slash128v6/DC28_Jack_Attack_Badge/eagle/Parts/1451-01.jpg

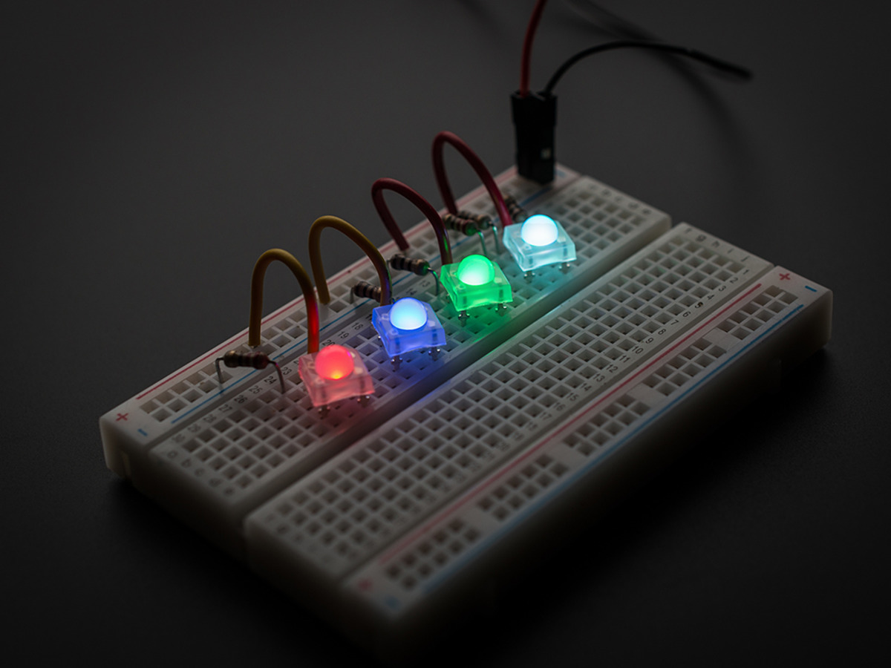
eagle/Parts/1451-01.jpg
