slash128v6/DC28_Jack_Attack_Badge/eagle/Media/DC-Jack_100x100_White-on-Black.bmp

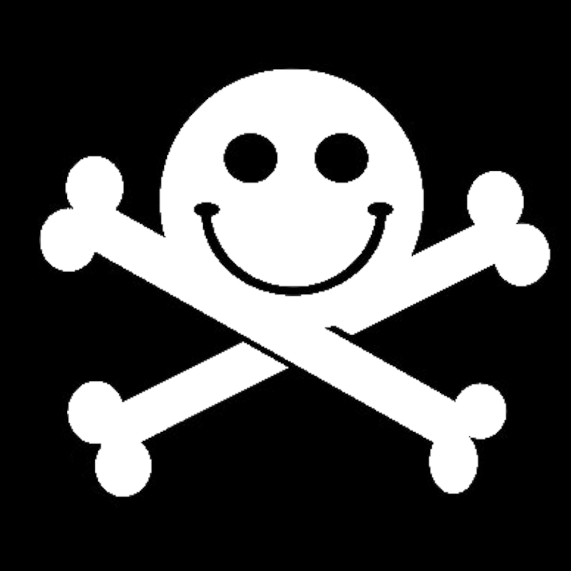
eagle/Media/DC-Jack_100x100_White-on-Black.bmp
