slash128v6/DC28_Jack_Attack_Badge/eagle/Parts/1334228050572109244.jpg

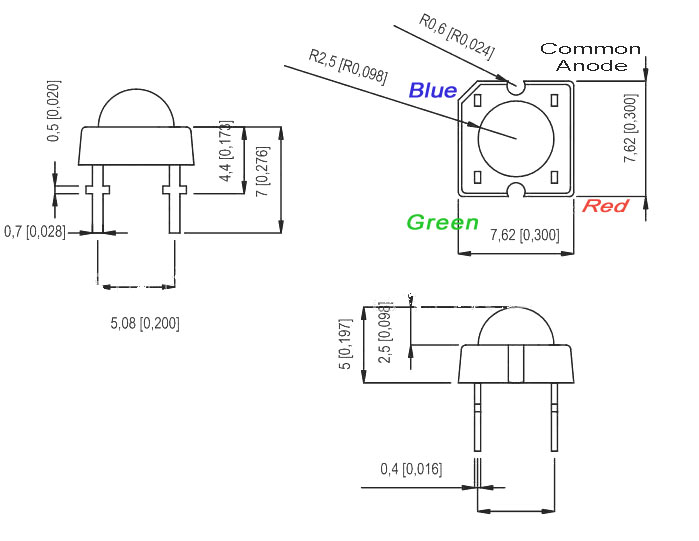
eagle/Parts/1334228050572109244.jpg
