slash128v6/DC28_Jack_Attack_Badge/eagle/Parts/1026.PDF

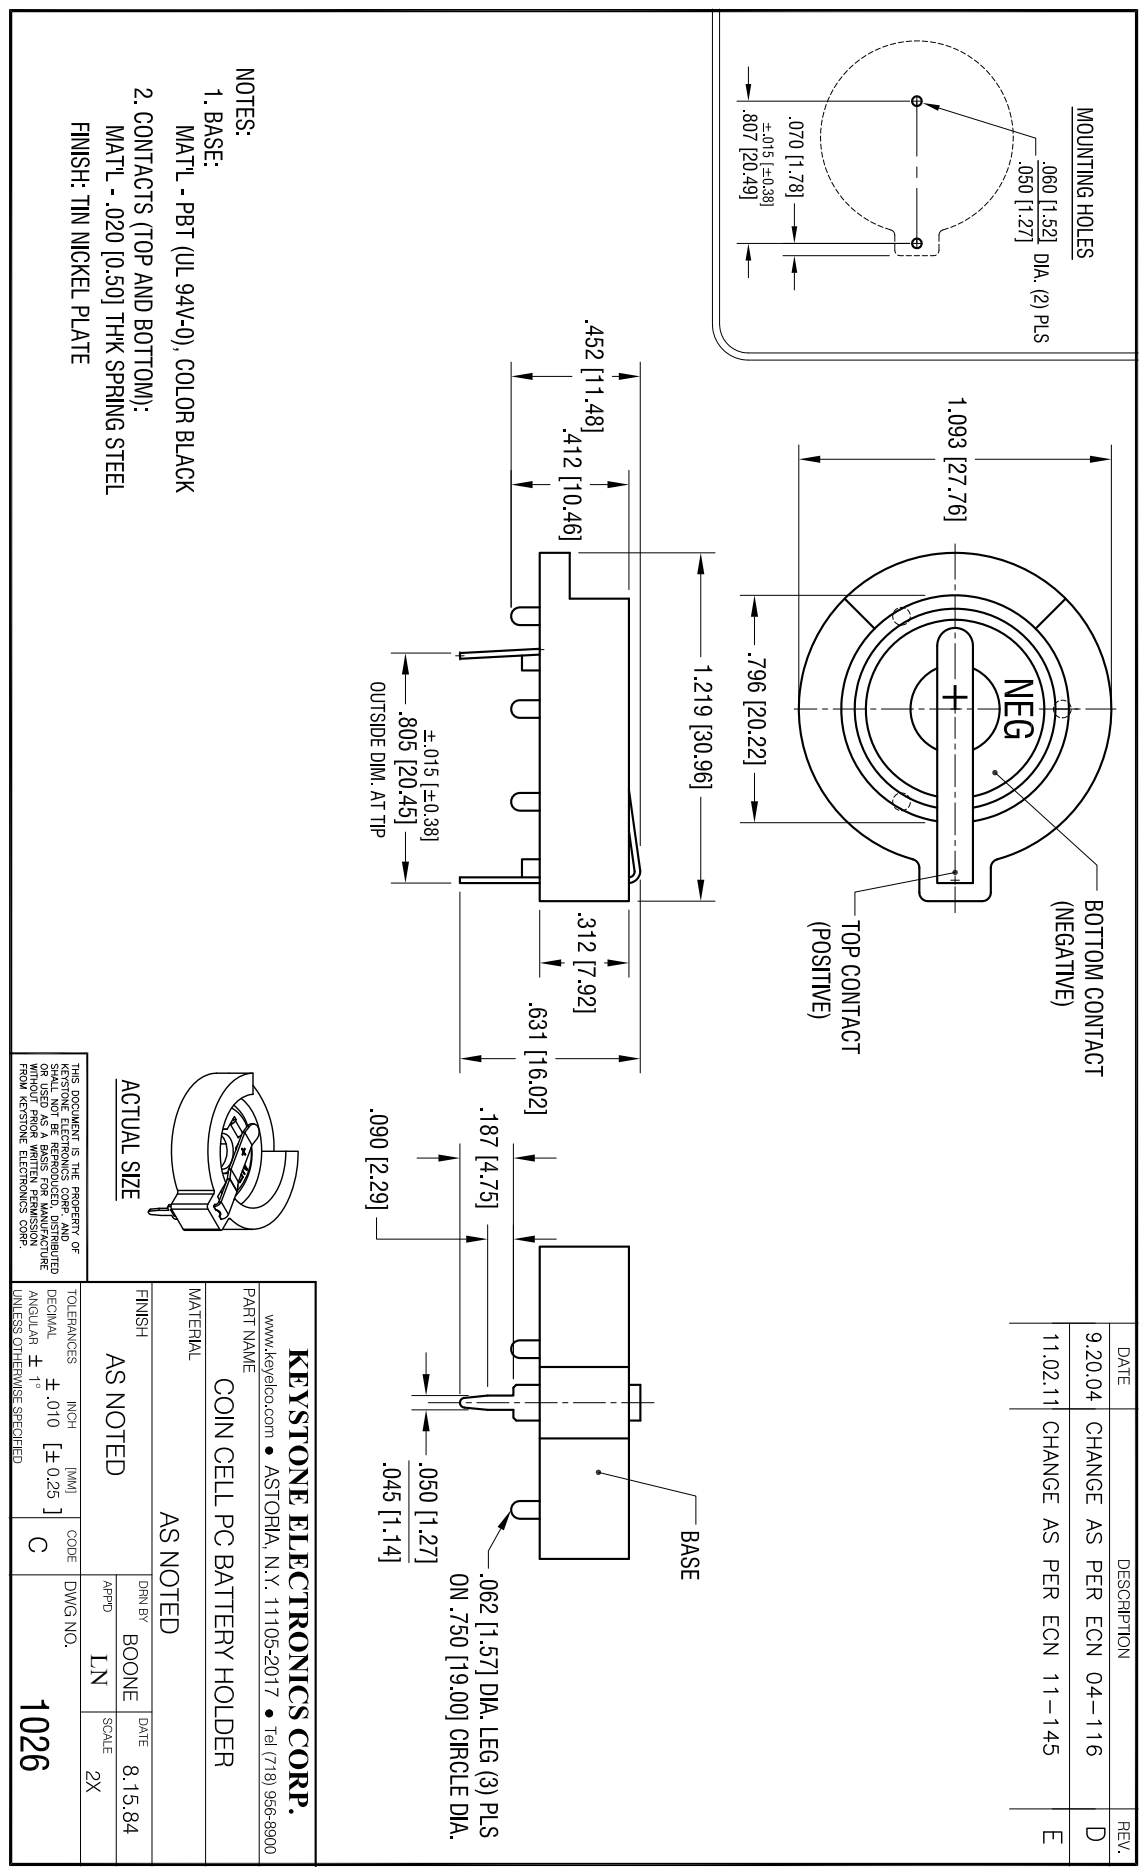
[picture p4: page 1]
