slash128v6/DC28_Jack_Attack_Badge/eagle/Output/Schematic/DC28_Jack-Attack_Badge.pdf

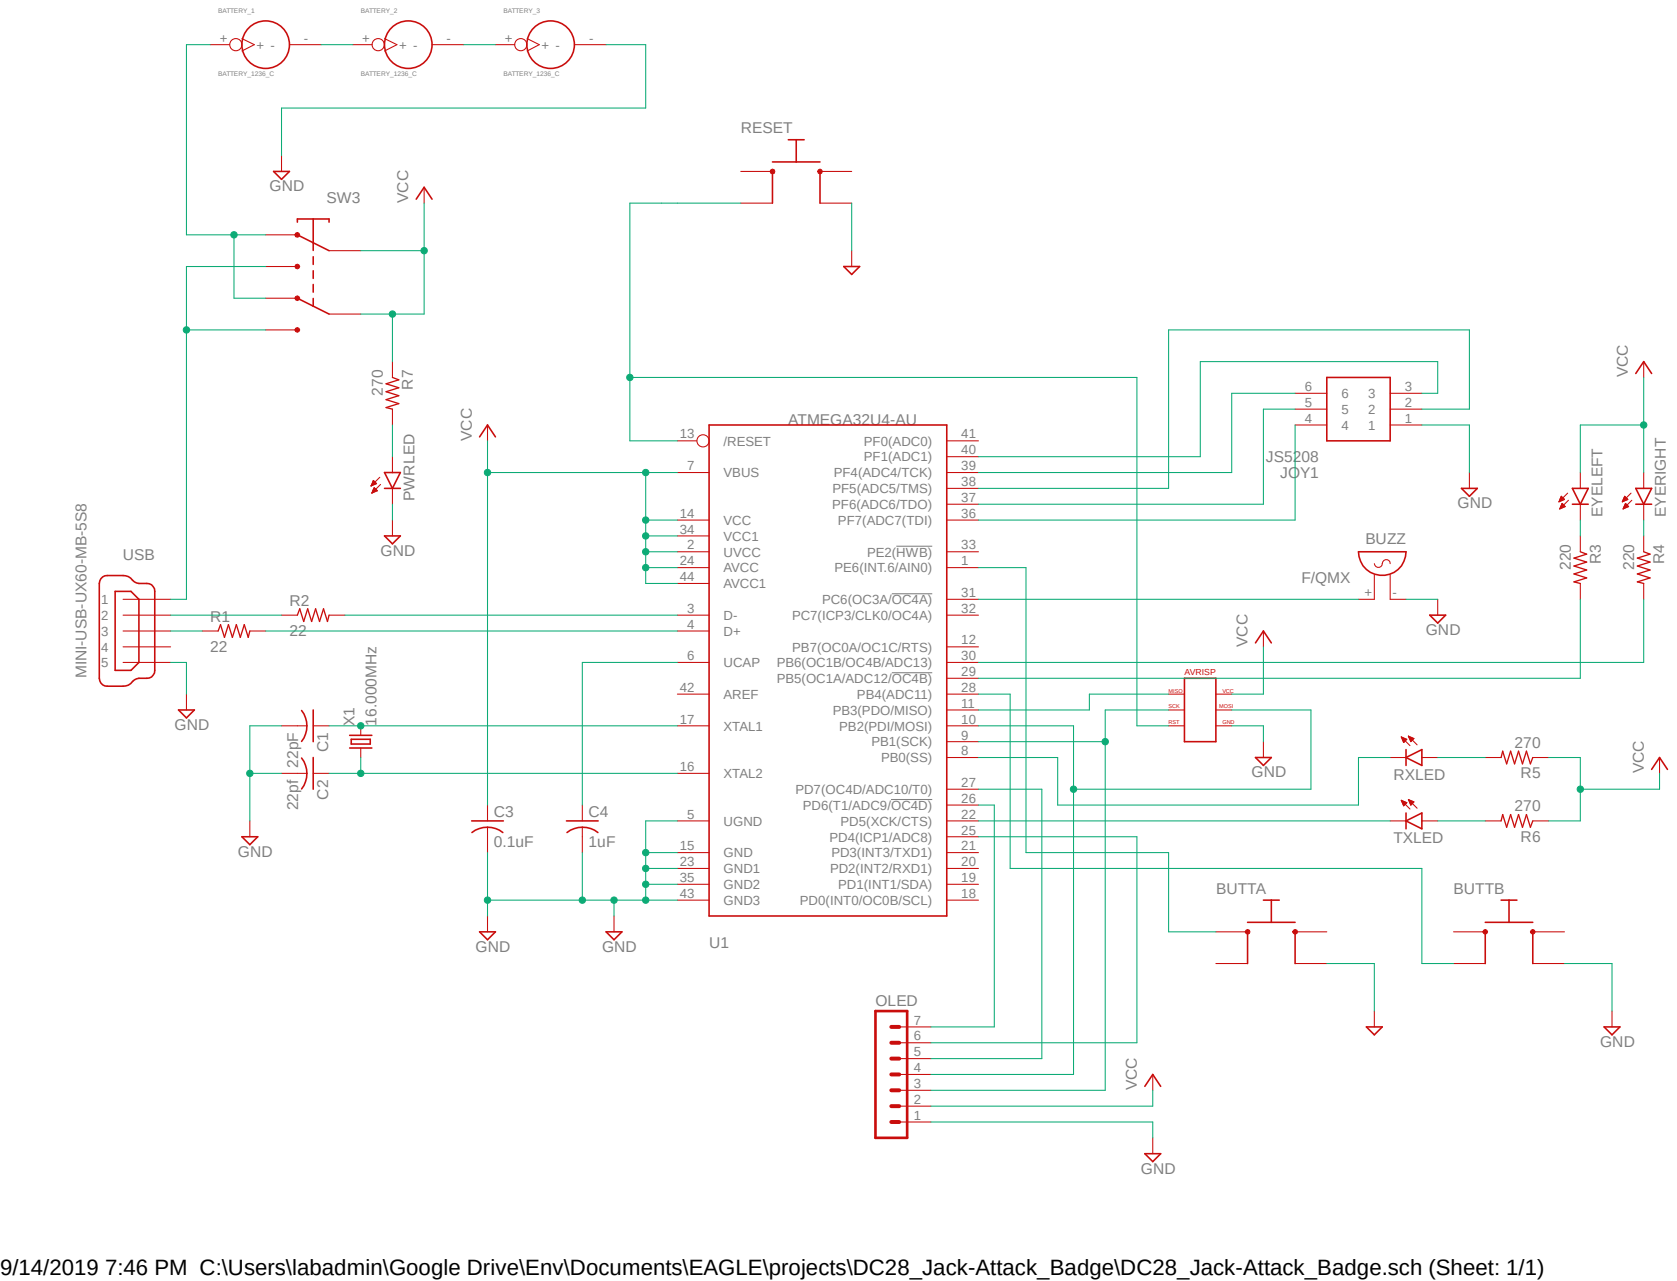
[picture p5: page 1]

AVRISP

MISO
