slash128v6/DC28_Jack_Attack_Badge/eagle/Output/Gerber/DC28_Jack-Attack_Badge-4_2019-11-18_Bottom.pdf

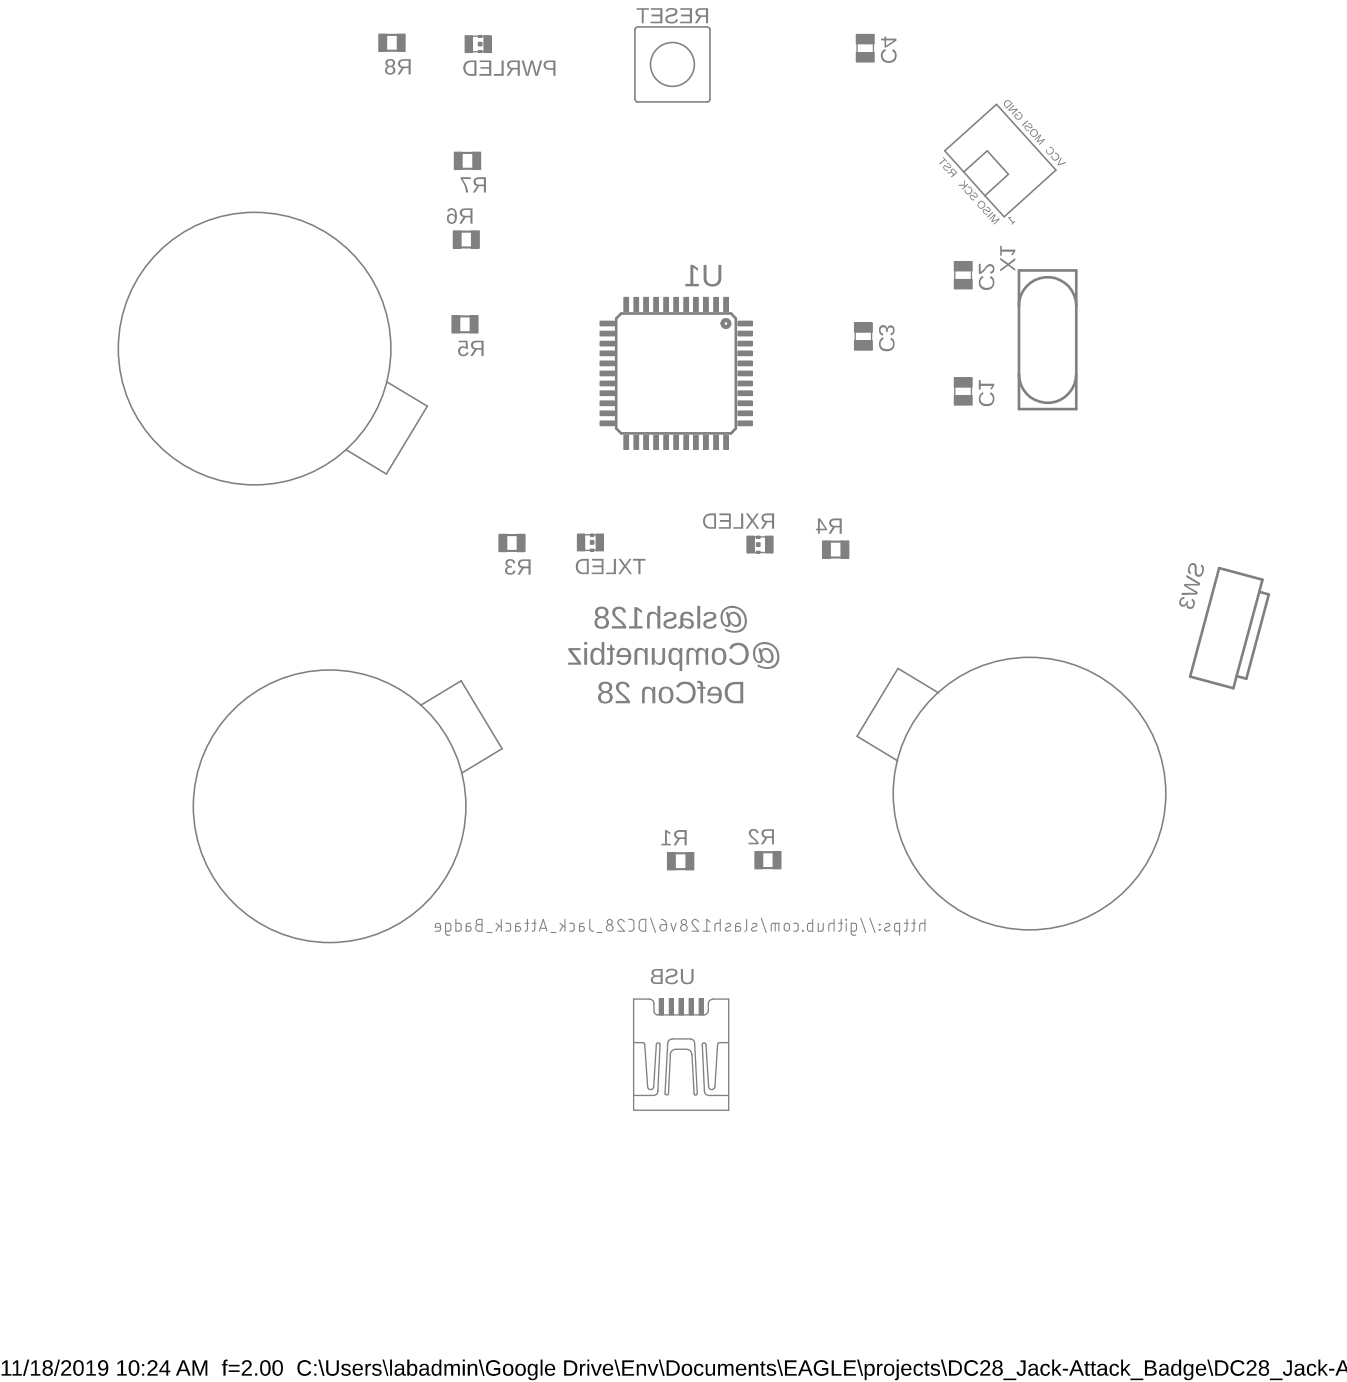
[picture p6: page 1]
