slash128v6/DC28_Jack_Attack_Badge/eagle/DC28_Jack-Attack_Badge-2.brd

## EAGLE design eagle/DC28_Jack-Attack_Badge-2.brd (2020-02-04)

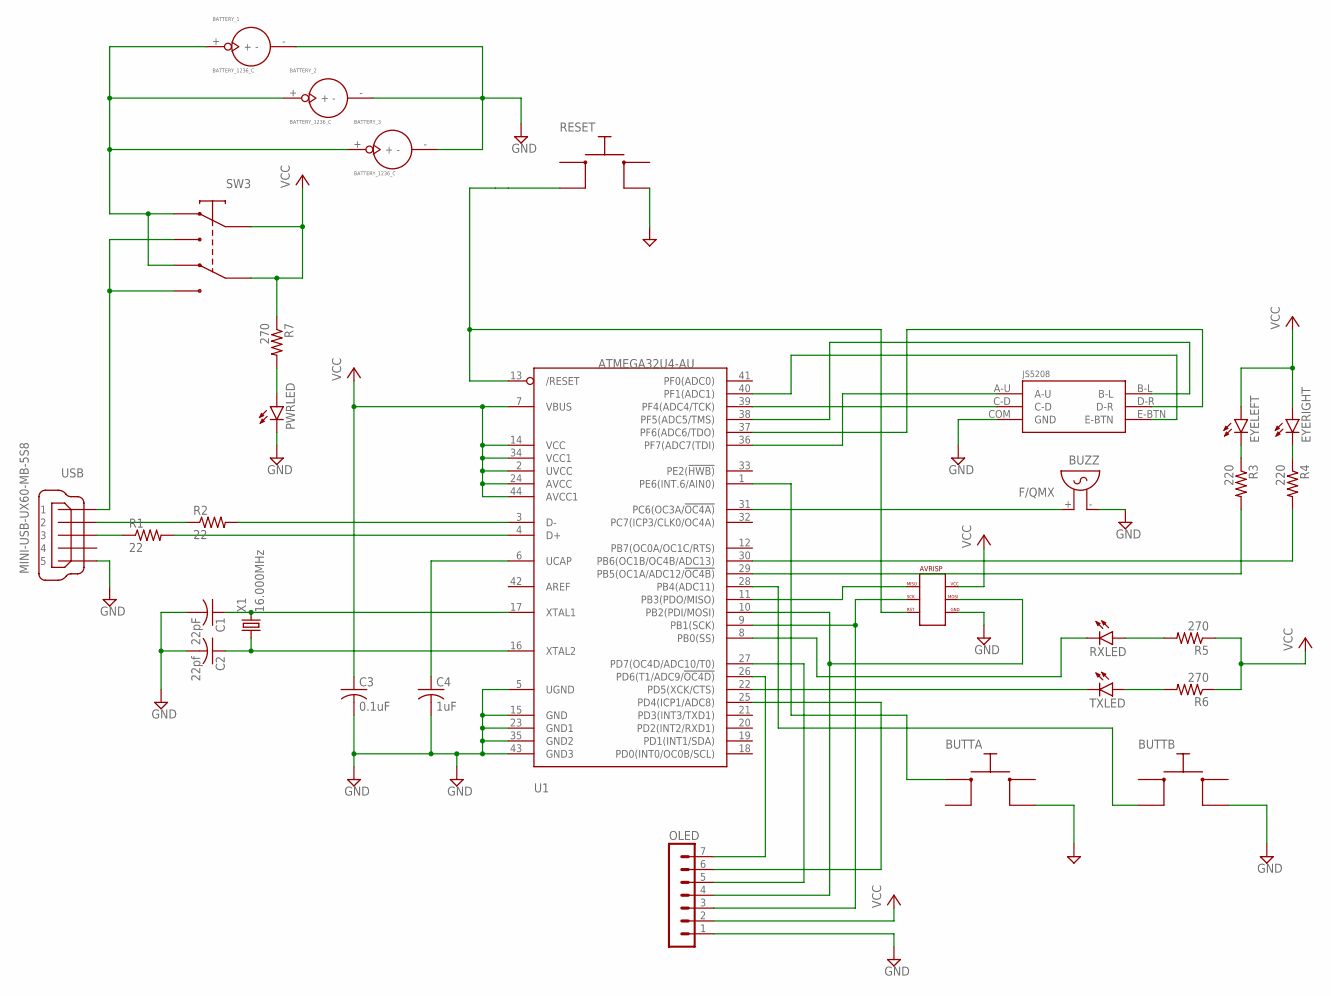
[picture p8: schematic DC28_Jack-Attack_Badge-2.sch]

Parts:
BATTERY_1, BATTERY_2, BATTERY_3: BATTERY_1236_C
BUTTA: PTS645; PTS645_SMD
BUTTB: PTS645; PTS645_SMD
BUZZ: F/QMX
C1: 22pF; C0805
C2: 22pf; C0805
C3: 0.1uF; C0805
C4: 1uF; C0805
EYELEFT: LED5MM
EYERIGHT: LED5MM
OLED: MA07-1
PWRLED: LEDCHIP-LED0805; CHIP-LED0805
R1, R2: 22; R0805
R3, R4: 220; R0805
R5, R6, R7: 270; R0805
RESET: PTS645; PTS645_SMD
RXLED: LEDCHIP-LED0805; CHIP-LED0805
SW3: JS202011AQN
TXLED: LEDCHIP-LED0805; CHIP-LED0805
U1: ATMEGA32U4-AU; TQFP44
U$1: AVRISP_POGO
U$2: JS5208; JS5208_PKG
USB: MINI-USB-UX60-MB-5S8; UX60-MB-5S8
X1: 16.000MHz; CSM-7X-DU

Connections:
BATT1: BATTERY_1.+, BATTERY_2.+, BATTERY_3.+, SW3.P$1 (1), SW3.P$4 (4)
GND: BATTERY_1.-, BATTERY_2.-, BATTERY_3.-, BUTTA.P$4 (4), BUTTB.P$4 (4), BUZZ.- (1), C1.2, C2.2, C3.2, C4.2, OLED.1, PWRLED.C, RESET.P$4 (4), U1.5 (UGND), U1.15 (GND), U1.23 (GND1), U1.35 (GND2), U1.43 (GND3), U$1.P$6, U$1.P$6B, U$2.COM (GND), USB.5
unnamed: R1.1, USB.3
unnamed: R2.2, U1.3 (D-)
unnamed: R2.1, USB.2
unnamed: R1.2, U1.4 (D+)
unnamed: C4.1, U1.6 (UCAP)
unnamed: BUTTA.P$1 (1), U1.1 (PE6(INT.6/AIN0))
unnamed: C2.1, U1.16 (XTAL2), X1.1
unnamed: C1.1, U1.17 (XTAL1), X1.2
unnamed: U1.36 (PF7(ADC7(TDI)), U$2.A-U
unnamed: U1.11 (PB3(PDO/MISO)), U$1.P$1, U$1.P$1B
unnamed: OLED.3, U1.9 (PB1(SCK)), U$1.P$3, U$1.P$3B
unnamed: OLED.4, U1.10 (PB2(PDI/MOSI)), U$1.P$4, U$1.P$4B
unnamed: U1.37 (PF6(ADC6/TDO)), U$2.D-R
unnamed: BUTTB.P$2 (2), U1.28 (PB4(ADC11))
unnamed: RESET.P$2 (2), U1.13 (/RESET), U$1.P$5, U$1.P$5B
unnamed: BUZZ.+ (2), U1.31 (PC6(OC3A/!OC4A))
unnamed: TXLED.C, U1.22 (PD5(XCK/CTS))
unnamed: U1.38 (PF5(ADC5/TMS)), U$2.B-L
unnamed: U1.39 (PF4(ADC4/TCK)), U$2.C-D
unnamed: R6.2, TXLED.A
unnamed: RXLED.C, U1.8 (PB0(SS))
unnamed: R5.2, RXLED.A
unnamed: U1.40 (PF1(ADC1)), U$2.E-BTN
unnamed: PWRLED.A, R7.2
unnamed: OLED.5, U1.27 (PD7(OC4D/ADC10/T0))
unnamed: OLED.6, U1.25 (PD4(ICP1/ADC8))
unnamed: OLED.7, U1.26 (PD6(T1/ADC9/!OC4D))
unnamed: R4.2, U1.30 (PB6(OC1B/OC4B/ADC13))
unnamed: R3.2, U1.29 (PB5(OC1A/ADC12/!OC4B))
unnamed: EYERIGHT.K (C), R4.1
unnamed: EYELEFT.K (C), R3.1
USB+5V: SW3.P$3 (3), SW3.P$6 (6), USB.1
VCC: C3.1, EYELEFT.A, EYERIGHT.A, OLED.2, R5.1, R6.1, R7.1, SW3.P$2 (2), SW3.P$5 (5), U1.2 (UVCC), U1.7 (VBUS), U1.14 (VCC), U1.24 (AVCC), U1.34 (VCC1), U1.44 (AVCC1), U$1.P$2, U$1.P$2B

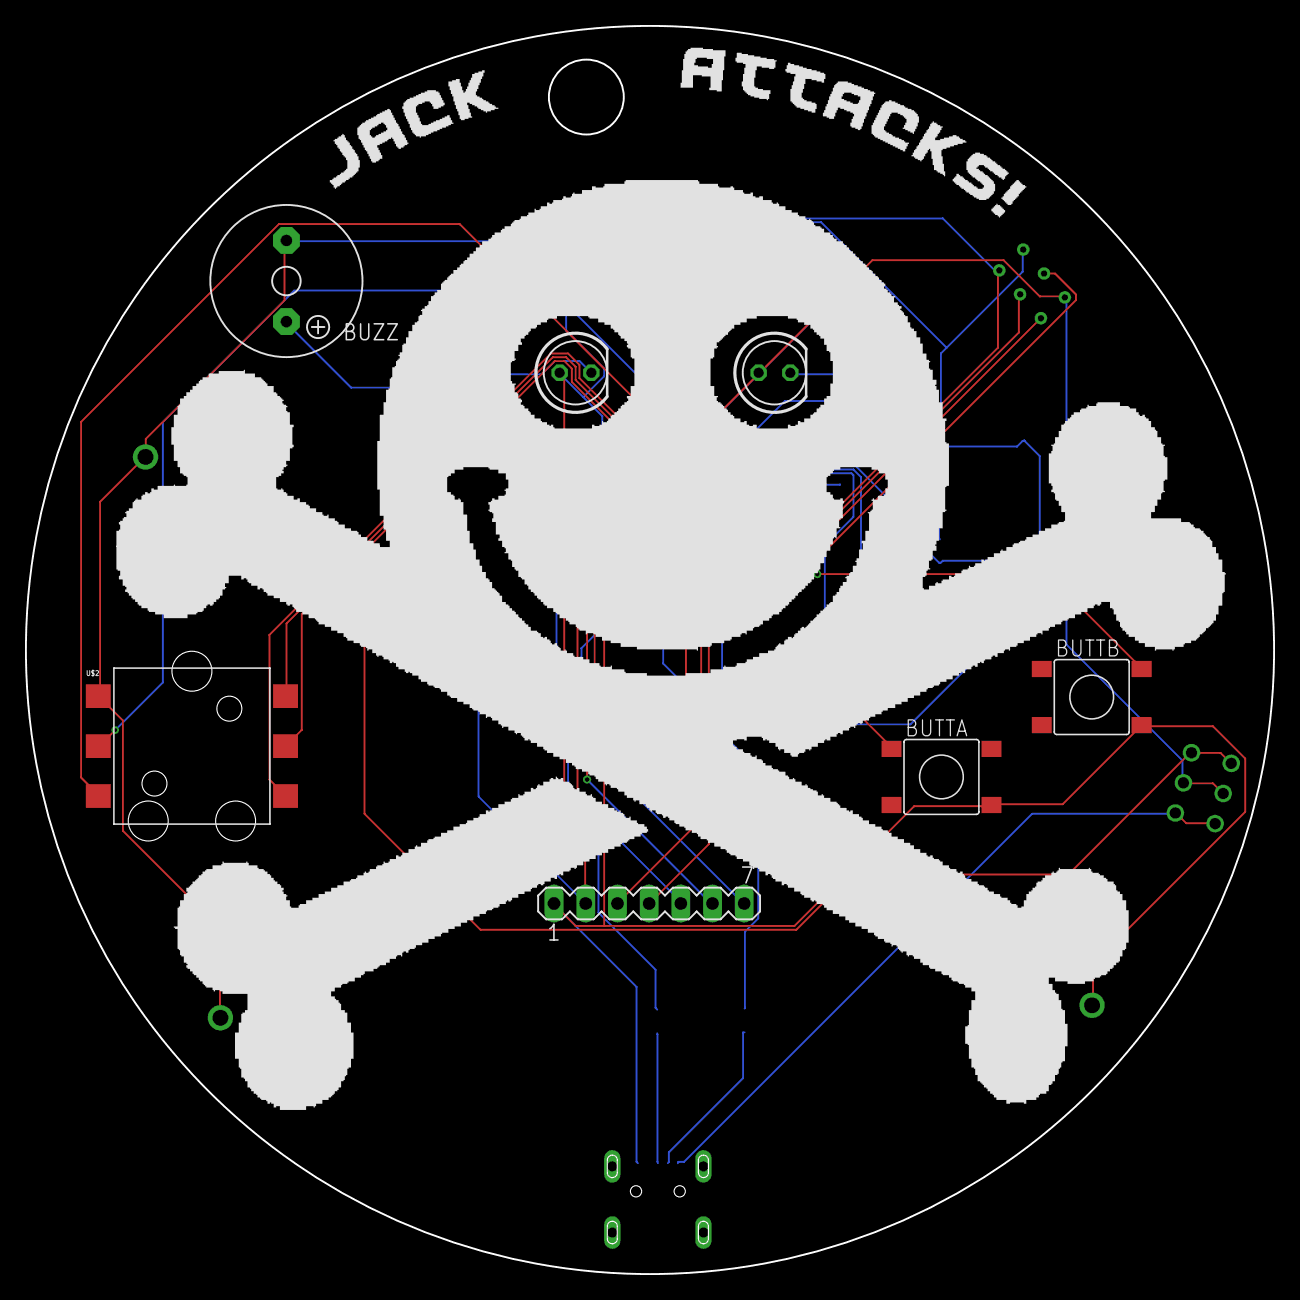
[picture p9: board DC28_Jack-Attack_Badge-2.brd from above]

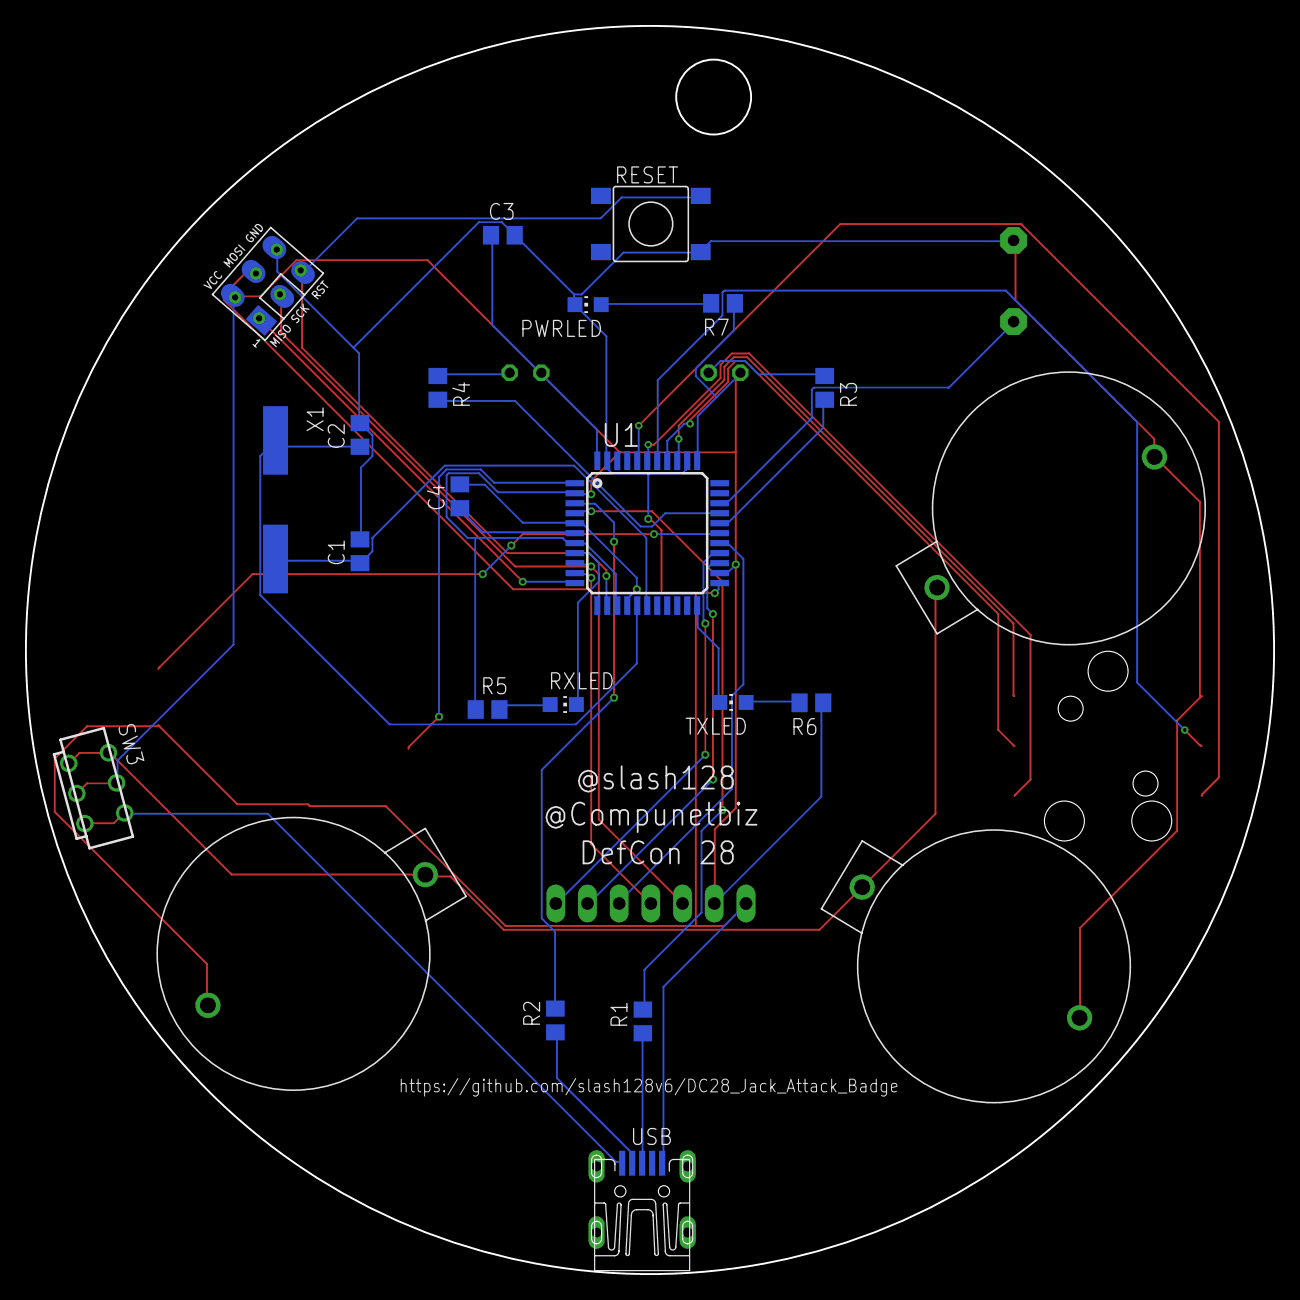
[picture p10: board DC28_Jack-Attack_Badge-2.brd from below]

Board: 2 copper layers, 100.0 x 100.0 mm, 30 parts (23 on the bottom side), 35 nets.
