slash128v6/DC28_Jack_Attack_Badge/sprites.h

// Graphics and objects
//
/*
Name:       DC28_Jack_Attack_Badge.ino
Created:	8/11/2019 9:25:15 PM
Author:     slash128
Notes:      Arduboy compatible
*/

#include <avr/pgmspace.h>

struct Object {
	signed int locX;
	signed int sizeX;
	signed int locY;
	signed int sizeY;
	unsigned int speed;
	unsigned char status; // 0 = Alive, 1 = Hit, 2 = Dead
};

// 'shipBMP', 8x16px
const unsigned char shipBMP [] PROGMEM = {
	0x80, 0xc0, 0xf8, 0xc0, 0xc0, 0xe0, 0xf8, 0xff, 0xf8, 0xe0, 0xc0, 0xc0, 0xf8, 0xc0, 0x80, 0x00
};

// 'shipSmallBMP', 4x8px
const unsigned char shipSmallBMP [] PROGMEM = {
	0x80, 0xc0, 0x80, 0xf0, 0xc0, 0x80, 0xc0, 0x00
};

// 'laserBMP', 8x2px
const unsigned char laserBMP [] PROGMEM = {
	0xaa, 0x55
};

// 'jackBMP', 16x16px
const unsigned char jackBMP [] PROGMEM = {
	0x00, 0x00, 0x03, 0x80, 0x07, 0xe0, 0x0d, 0xb0, 0x4d, 0xb2, 0x6f, 0xd6, 0xfb, 0xff, 0x0f, 0xf8,
	0x07, 0xe0, 0x03, 0xc0, 0x0e, 0x70, 0x78, 0x1e, 0x20, 0x0c, 0x20, 0x08, 0x00, 0x00, 0x00, 0x00
};

// 'explosionBMP', 16x8px
const unsigned char explosionBMP [] PROGMEM = {
	0x08, 0x80, 0x45, 0x10, 0x20, 0x20, 0x10, 0x40,	0xc0, 0x18, 0x10, 0x40, 0x20, 0x20, 0x45, 0x10
};

// 'bgrnd1BMP', 128x64px
const unsigned char bgrnd1BMP [] PROGMEM = {
	0x00, 0x00, 0x00, 0x00, 0x00, 0x00, 0x00, 0x00, 0x00, 0x00, 0x00, 0x00, 0x00, 0x00, 0x00, 0x00,
	0x20, 0x00, 0x08, 0x00, 0x00, 0x00, 0x00, 0x00, 0x00, 0x00, 0x00, 0x00, 0x00, 0x00, 0x00, 0x00,
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
};

// 'ghost', 16x16px
const unsigned char ghostBMP [] PROGMEM = {
	0x03, 0xc0, 0x0f, 0xf0, 0x1f, 0xf8, 0x3f, 0xfc, 0x3f, 0xfc, 0x7f, 0xfe, 0x73, 0xce, 0x73, 0xce,
	0x7f, 0xfe, 0x7f, 0xfe, 0x7f, 0xfe, 0x7f, 0xfe, 0x7f, 0xfe, 0x7f, 0xfe, 0x6e, 0x76, 0x44, 0x22
};
