slash128v6/DC28_Jack_Attack_Badge/(commit log)

2019-11-27 Updated with RGB LEDs
2020-02-04 Added eagle files
    [BOM Template.xlsx, DC28_Jack-Attack_Badge-1.brd, DC28_Jack-Attack_Badge-1.sch, DC28_Jack-Attack_Badge-2.brd, DC28_Jack-Attack_Badge-2.sch, DC28_Jack-Attack_Badge-3.brd, DC28_Jack-Attack_Badge-3.sch, DC28_Jack-Attack_Badge-4.brd]
